fransschreuder/gpibusb-pcb/usb_to_gpib.pdf

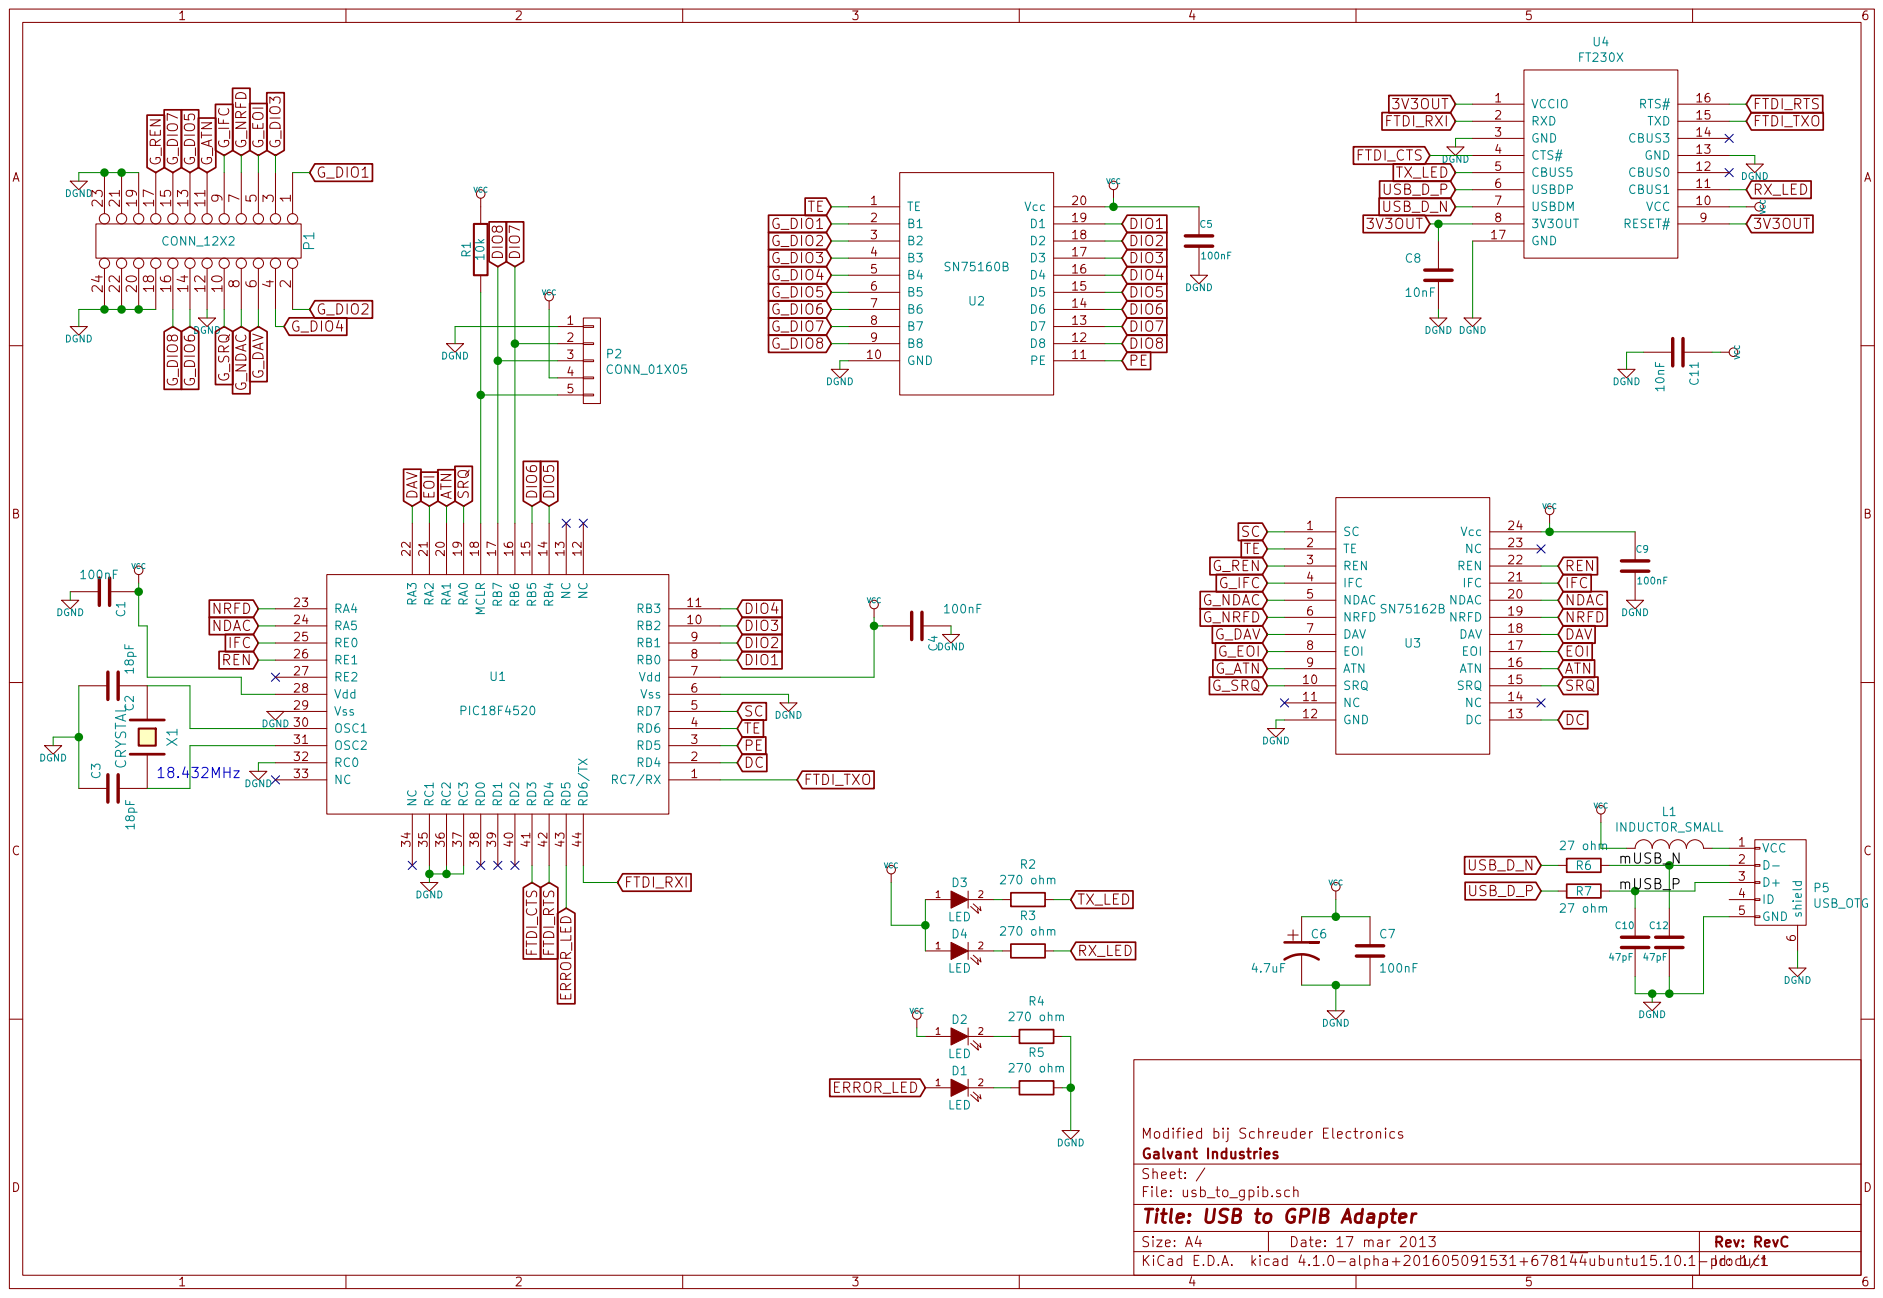
[picture p1: page 1]

File: usb_to_gpib.sch Sheet: / Galvant Industries Modified bij Schreuder Electronics 18.432MHz

Id: 1/1 Title: USB to GPIB Adapter
