fransschreuder/gpibusb-pcb/usb_to_gpib.kicad_pcb

## KiCad design usb_to_gpib.kicad_pcb (2016-09-19)

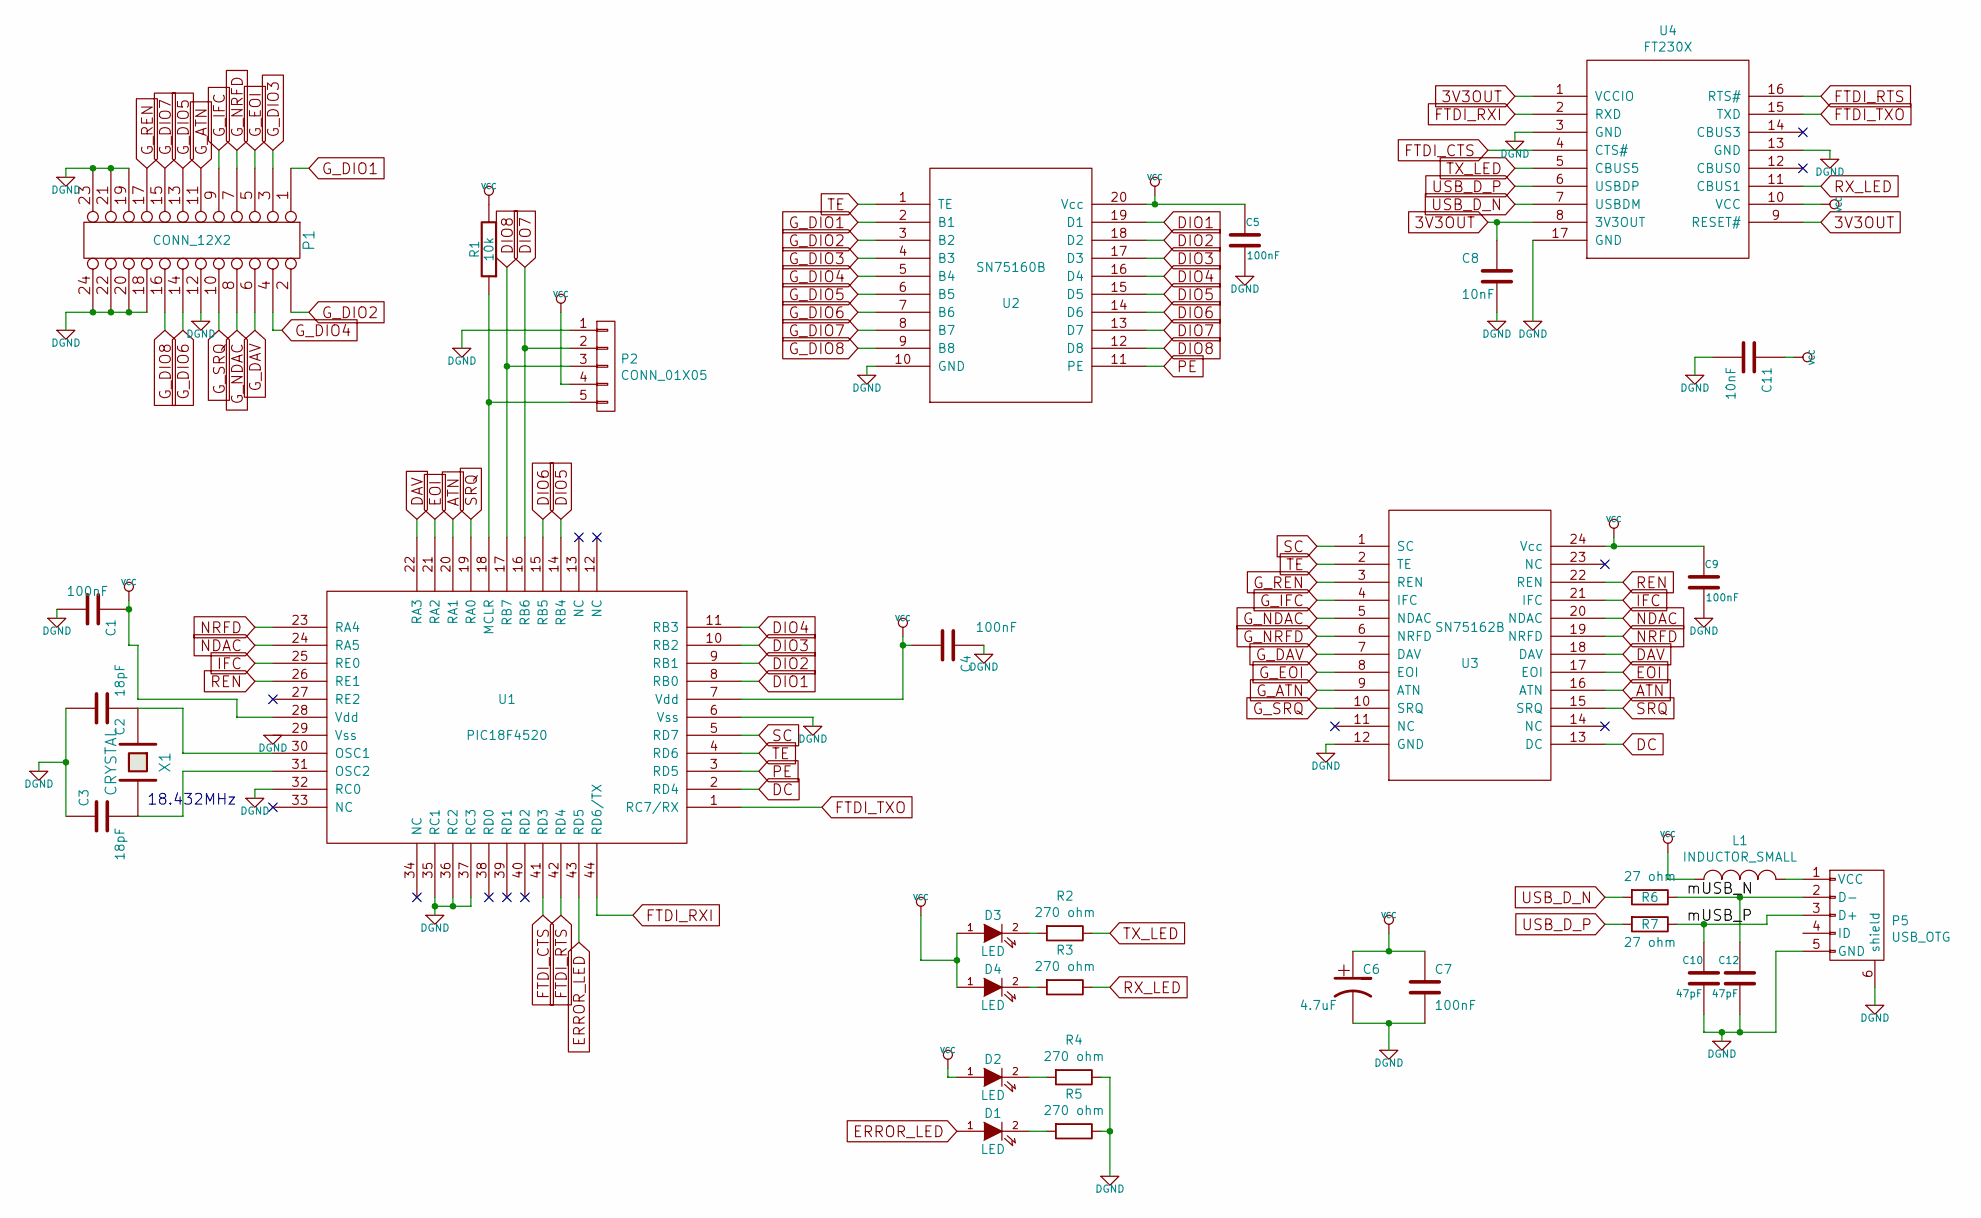
[picture p2: schematic usb_to_gpib.sch, USB to GPIB Adapter]

Parts:
C1, C4, C5, C7, C9: 100nF; C_0603
C2, C3: 18pF; C_0603
C6: 4.7uF; C_1210
C8, C11: 10nF; C_0603
C10, C12: 47pF; C_0603
D1, D2, D3, D4: LED; LED_0805
L1: INDUCTOR_SMALL; R_0603
P1: CONN_12X2; gpib_conn_male
P2: CONN_01X05; Pin_Header_Straight_1x05
P5: USB_OTG; USB_Mini-B
R1: 10k; R_0603
R2, R3, R4, R5: 270 ohm; R_0603
R6, R7: 27 ohm; R_0603
U1: PIC18F4520
U2: SN75160B; MODULE
U3: SN75162B; MODULE
U4: FT230X; MODULE
X1: CRYSTAL; ABM3

Connections:
3V3OUT: C8.1, U4.1 (VCCIO), U4.8 (3V3OUT), U4.9 (RESET#)
/mUSB_N: C12.1, P5.2 (D-), R6.1
/mUSB_P: C10.1, P5.3 (D+), R7.1
ATN: U1.20 (RA1), U3.16 (ATN)
DAV: U1.22 (RA3), U3.18 (DAV)
DC: U1.2 (RD4), U3.13 (DC)
DGND: C1.2, C2.2, C3.1, C4.1, C5.2, C6.2, C7.2, C8.2, C9.2, C10.2, C11.2, C12.2, P1.12, P1.18, P1.19, P1.20, P1.21, P1.22, P1.23, P1.24, P2.1, P5.5 (GND), P5.6 (shield), R4.1, R5.1, U1.6 (Vss), U1.29 (Vss), U1.32 (RC0), U1.35 (RC1), U1.36 (RC2), U1.37 (RC3), U2.10 (GND), U3.12 (GND), U4.3 (GND), U4.13 (GND), U4.17 (GND)
DIO1: U1.8 (RB0), U2.19 (D1)
DIO2: U1.9 (RB1), U2.18 (D2)
DIO3: U1.10 (RB2), U2.17 (D3)
DIO4: U1.11 (RB3), U2.16 (D4)
DIO5: U1.14 (RB4), U2.15 (D5)
DIO6: U1.15 (RB5), U2.14 (D6)
DIO7: P2.2, U1.16 (RB6), U2.13 (D7)
DIO8: P2.3, U1.17 (RB7), U2.12 (D8)
EOI: U1.21 (RA2), U3.17 (EOI)
ERROR_LED: D1.1 (A), U1.43 (RD5)
FTDI_CTS: U1.41 (RD3), U4.4 (CTS#)
FTDI_RTS: U1.42 (RD4), U4.16 (RTS#)
FTDI_RXI: U1.44 (RD6/TX), U4.2 (RXD)
FTDI_TXO: U1.1 (RC7/RX), U4.15 (TXD)
G_ATN: P1.11, U3.9 (ATN)
G_DAV: P1.6, U3.7 (DAV)
G_DIO1: P1.1, U2.2 (B1)
G_DIO2: P1.2, U2.3 (B2)
G_DIO3: P1.3, U2.4 (B3)
G_DIO4: P1.4, U2.5 (B4)
G_DIO5: P1.13, U2.6 (B5)
G_DIO6: P1.14, U2.7 (B6)
G_DIO7: P1.15, U2.8 (B7)
G_DIO8: P1.16, U2.9 (B8)
G_EOI: P1.5, U3.8 (EOI)
G_IFC: P1.9, U3.4 (IFC)
G_NDAC: P1.8, U3.5 (NDAC)
G_NRFD: P1.7, U3.6 (NRFD)
G_REN: P1.17, U3.3 (REN)
G_SRQ: P1.10, U3.10 (SRQ)
IFC: U1.25 (RE0), U3.21 (IFC)
NDAC: U1.24 (RA5), U3.20 (NDAC)
NRFD: U1.23 (RA4), U3.19 (NRFD)
unnamed: C2.1, U1.30 (OSC1), X1.1
unnamed: C3.2, U1.31 (OSC2), X1.2
unnamed: D1.2 (K), R5.2
unnamed: D2.2 (K), R4.2
unnamed: D3.2 (K), R2.2
unnamed: D4.2 (K), R3.2
unnamed: L1.2, P5.1 (VCC)
unnamed: P2.5, R1.1, U1.18 (MCLR)
PE: U1.3 (RD5), U2.11 (PE)
REN: U1.26 (RE1), U3.22 (REN)
RX_LED: R3.1, U4.11 (CBUS1)
SC: U1.5 (RD7), U3.1 (SC)
SRQ: U1.19 (RA0), U3.15 (SRQ)
TE: U1.4 (RD6), U2.1 (TE), U3.2 (TE)
TX_LED: R2.1, U4.5 (CBUS5)
USB_D_N: R6.2, U4.7 (USBDM)
USB_D_P: R7.2, U4.6 (USBDP)
VCC: C1.1, C4.2, C5.1, C6.1, C7.1, C9.1, C11.1, D2.1 (A), D3.1 (A), D4.1 (A), L1.1, P2.4, R1.2, U1.7 (Vdd), U1.28 (Vdd), U2.20 (Vcc), U3.24 (Vcc), U4.10 (VCC)

Notes on the sheet:
18.432MHz

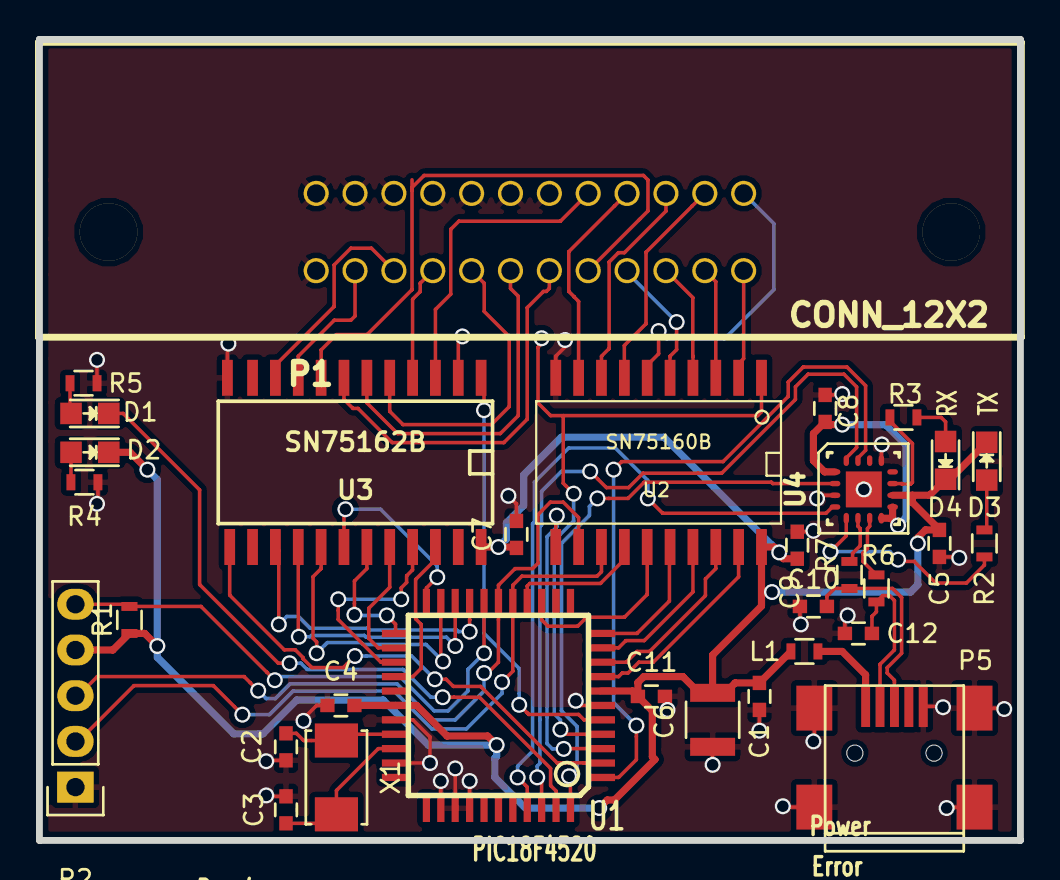
[picture p3: board usb_to_gpib.kicad_pcb from above]

Board: 2 copper layers, 54.5 x 44.5 mm, 32 parts (0 on the bottom side), 58 nets.
