fransschreuder/gpibusb-pcb/(commit log)

2016-09-19 Some modifications: * removed exotic dual resistors * added usbpicprog compatible isp header * smaller board * usb mini connector
    [usb_to_gpib-B.Mask.gbs, usb_to_gpib-B.SilkS.gbo, usb_to_gpib-B_Cu.gbl, usb_to_gpib-B_Mask.gbs, usb_to_gpib-B_SilkS.gbo, usb_to_gpib-Component.gtl, usb_to_gpib-Copper.gbl, usb_to_gpib-Edge.Cuts.gm1]
2016-09-19 renamed edge cuts to .gko
    [usb_to_gpib-Edge.Cuts.gko]
