fransschreuder/gpibusb-pcb/(notices)

Notices in the files:
usb_to_gpib.kicad_pcb:
Released under Creative Commons
Attribution-ShareAlike 3.0 License
